futation/Bionic_Snake_Robot/hardware/BOM_Bus-LinkV2.1_bus-linkV2.1_2026-06-18.xlsx

No. | Quantity | Comment | Designator | Footprint | Value | Manufacturer Part | Manufacturer | Supplier Part | Supplier
1 | 3 | 100nF | C1,C17,C21 | C0603 | 100nF | CC0603KRX7R9BB104 | YAGEO(国巨) | C14663 | LCSC
2 | 2 | 10uF | C2,C22 | C1206 | 10uF | CL31B106KBHNNNE | SAMSUNG(三星) | C89632 | LCSC
3 | 1 | 10nF | C3 | C0603 | 10nF | CL10B103KB8NNNC | SAMSUNG(三星) | C1589 | LCSC
4 | 1 | 220uF | C4 | CAP-SMD_BD6.3-L6.6-W6.6-LS7.3-FD-H7.7 | 220uF | JVJ25V220M6x8 | JIERR(捷而瑞) | C46550404 | LCSC
5 | 1 | 330nF | C5 | C0603 | 330nF | FCC0603B334K500CT | FOJAN(富捷) | C7419419 | LCSC
6 | 2 | 100nF | C15,C16 | C0603 |  | CGA0603X7R104K500JT | HRE(芯声) | C6119867 | LCSC
7 | 1 | 1000uF | C19 | CAP-TH_BD10.0-F5.00-D0.6-FD | 1000uF | PA35V1000M10x15 | JIERR(捷而瑞) | C46550434 | LCSC
8 | 1 | 330uF | C24 | CAP-TH_BD6.3-P2.50-D0.6-FD-1 | 330uF | PA16V330M6x9 | JIERR(捷而瑞) | C46550446 | LCSC
9 | 2 | PH-3A | CN4,CN5 | CONN-TH_3P-P2.00_HCTL_PH-3A_C2908624 |  | PH-3A | HCTL(华灿天禄) | C2908624 | LCSC
10 | 1 | 1SMA5927A | D2 | SMA_L4.3-W2.6-LS5.0-RD |  | 1SMA5927A | R+O(宏嘉诚) | C19077489 | LCSC
11 | 1 | SMAJ15CA | D3 | SMA_L4.3-W2.6-LS5.0-BI |  | SMAJ15CA | R+O(宏嘉诚) | C19077536 | LCSC
12 | 1 | SS54 | D4 | SMA_L4.3-W2.6-LS5.0-FD |  | SS54 | R+O(宏嘉诚) | C7420369 | LCSC
13 | 1 | ST2045 | D5 | TO-277_3P-L5.4-W4.0-LS6.5-BR |  | ST2045 | MDD(辰达半导体) | C840773 | LCSC
14 | 1 | DC-005-A200 | DC2 | DC-IN-TH_DC-005-A200 |  | DC-005-A200 | XUNPU(讯普) | C720557 | LCSC
15 | 1 | BSMD1206-300-6V | F1 | F1206 |  | BSMD1206-300-6V | BHFUSE(佰宏) | C883136 | LCSC
16 | 1 | 2920L1400SL16GRG | F2 | F2920 |  | 2920L1400SL16GRG | LUTE(陆特) | C49196651 | LCSC
17 | 2 | PZ254V-11-07P | H2,H3 | HDR-TH_7P-P2.54-V-M |  | PZ254V-11-07P | XFCN(兴飞) | C492406 | LCSC
18 | 1 | 22uH | L1 | IND-SMD_L7.3-W6.6 | 22uH | YSPI0740-220M | YJYCOIN(益嘉源) | C718397 | LCSC
19 | 3 | XL-1608SURC-06 | LED1,RX,TX | LED0603-RD_RED |  | XL-1608SURC-06 | XINGLIGHT(成兴光) | C965799 | LCSC
20 | 1 | AOD4185 | Q1 | TO-252-3_L6.6-W6.1-P4.57-LS9.9-BR-CW |  | AOD4185 | AOS | C400894 | LCSC
21 | 5 | 1kΩ | R1,R7,R8,R9,R11 | R0603 | 1kΩ | 0603WAF1001T5E | UNI-ROYAL(厚声) | C21190 | LCSC
22 | 1 | 10kΩ | R2 | R0603 | 10kΩ | FRC0603F1002TS | FOJAN(富捷) | C2906982 | LCSC
23 | 1 | 3.24kΩ | R3 | R0603 | 3.24kΩ | 0603WAF3241T5E | UNI-ROYAL(厚声) | C22994 | LCSC
24 | 1 | 500kΩ | R4 | R0603 | 500kΩ | AR03BTCX5003N | Viking(光颉) | C2902631 | LCSC
25 | 1 | 100kΩ | R5 | R0603 | 100kΩ | RT0603BRD07100KL | YAGEO(国巨) | C122538 | LCSC
26 | 1 | 0Ω | R6 | R1206 | 0Ω | RE1206F1R000 | JIERR(捷而瑞) | C46961765 | LCSC
27 | 2 | 47Ω | R17,R18 | R0603 | 47Ω | 0603WAF470JT5E | UNI-ROYAL(厚声) | C23182 | LCSC
28 | 1 | SS-12D10L5 | SW1 | SW-TH_SS-12D10L5 |  | SS-12D10L5 | XKB Connection(中国星坤) | C319012 | LCSC
29 | 1 | MC74HC126ADR2G | U2 | SOIC-14_L8.7-W3.9-P1.27-LS6.0-BL |  | MC74HC126ADR2G | onsemi(安森美) | C233530 | LCSC
30 | 1 | ESP32-S3-Zero 排针板 | U4 | ESP32-S3-Zero 排针
31 | 1 | 74AHC1G04W5-7 | U5 | SOT-25_L3.0-W1.6-P0.95-LS2.8-BL |  | 74AHC1G04W5-7 | DIODES(美台) | C460486 | LCSC
32 | 1 | TPS5430DDAR | U7 | ESOP-8_L4.9-W3.9-P1.27-LS6.0-TL-EP |  | TPS5430DDAR | TI(德州仪器) | C9864 | LCSC
33 | 2 | ZX-QC66-7.5TP | U8,U9 | KEY-SMD_4P-L6.0-W6.0-P4.50-LS8.6 |  | ZX-QC66-7.5TP | Megastar(兆星) | C7470157 | LCSC
