futation/Bionic_Snake_Robot/docs/运动算法/算法提炼.pdf

# 理论模型

# 连续模型

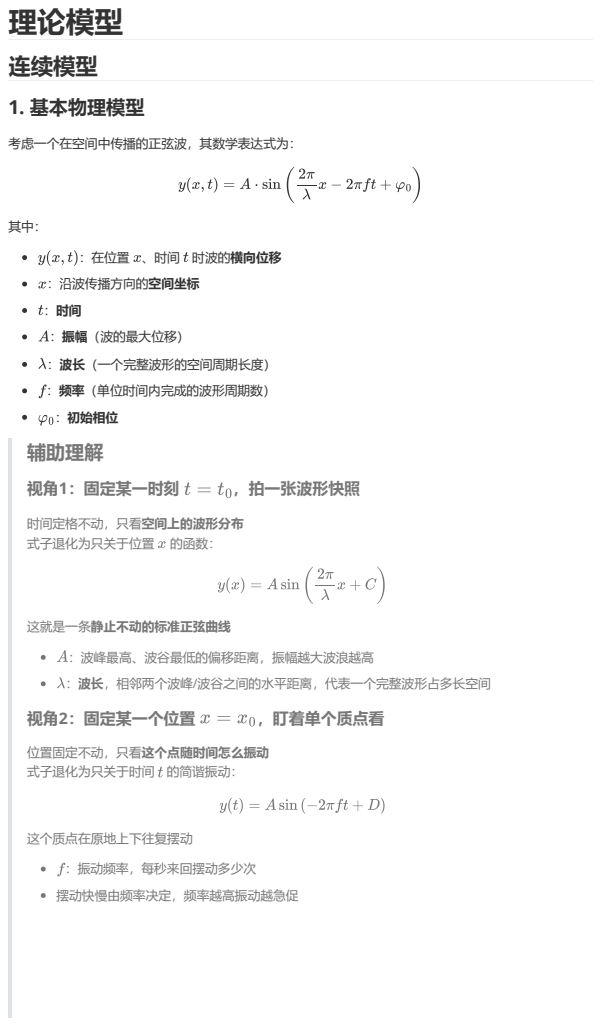
[picture p25: page 1]
1. 基本物理模型; 考虑一个在空间中传播的正弦波，其数学表达式为：; 视角1：固定某一时刻; ，拍一张波形快照; 时间定格不动，只看空间上的波形分布 式子退化为只关于位置 的函数：; 视角2：固定某一个位置; ，盯着单个质点看; 位置固定不动，只看这个点随时间怎么振动 式子退化为只关于时间 的简谐振动：; 这个质点在原地上下往复摆动; ：振动频率，每秒来回摆动多少次; 摆动快慢由频率决定，频率越高振动越急促

：在位置 、时间 时波的横向位移
：沿波传播方向的空间坐标
：振幅（波的最大位移）
：波长（一个完整波形的空间周期长度）
：频率（单位时间内完成的波形周期数）
：初始相位
辅助理解

这就是一条静止不动的标准正弦曲线
：波峰最高、波谷最低的偏移距离，振幅越大波浪越高
：波长，相邻两个波峰/波谷之间的水平距离，代表一个完整波形占多长空间

### 图像理解：二维动态波形图

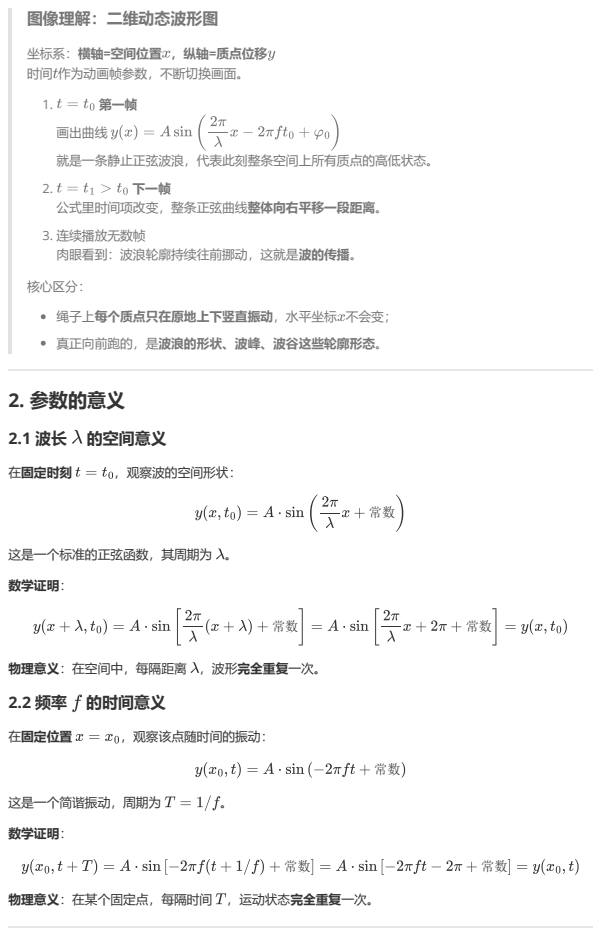
[picture p26: page 2]
2. 参数的意义; 2.1 波长 的空间意义; 在固定时刻; ，观察波的空间形状：; 这是一个标准的正弦函数，其周期为 。; 数学证明：; 在固定位置; ，观察该点随时间的振动：; 这是一个简谐振动，周期为

坐标系：横轴=空间位置 ，纵轴=质点位移
时间 作为动画帧参数，不断切换画面。
1. 第一帧
画出曲线
就是一条静止正弦波浪，代表此刻整条空间上所有质点的高低状态。
2. 下一帧
公式里时间项改变，整条正弦曲线整体向右平移一段距离。
3. 连续播放无数帧
肉眼看到：波浪轮廓持续往前挪动，这就是波的传播。

核心区分：
绳子上每个质点只在原地上下竖直振动，水平坐标 不会变；
真正向前跑的，是波浪的形状、波峰、波谷这些轮廓形态。

物理意义：在空间中，每隔距离 ，波形完全重复一次。
2.2 频率 的时间意义

物理意义：在某个固定点，每隔时间 ，运动状态完全重复一次。

## 3. 波的传播速度(相速度)

# 离散化变换

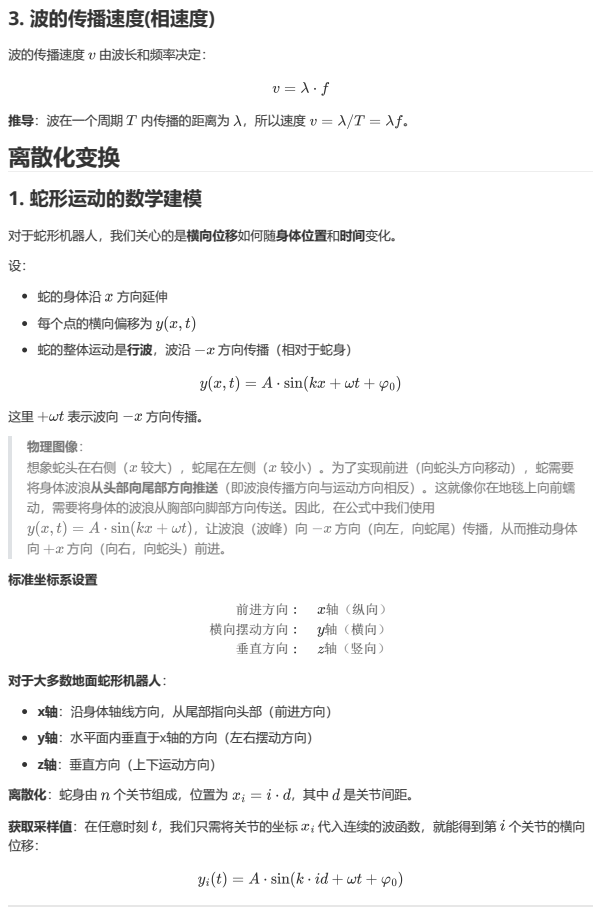
[picture p27: page 3]
波的传播速度 由波长和频率决定：; 推导：波在一个周期 内传播的距离为 ，所以速度; 1. 蛇形运动的数学建模; 对于蛇形机器人，我们关心的是横向位移如何随身体位置和时间变化。; 蛇的身体沿 方向延伸; 每个点的横向偏移为; 蛇的整体运动是行波，波沿; 方向传播（相对于蛇身）; 表示波向; 方向传播。; ，让波浪（波峰）向; 方向（向左，向蛇尾）传播，从而推动身体; 方向（向右，向蛇头）前进。; 标准坐标系设置; 前进方向; 横向摆动方向; 垂直方向; 对于大多数地面蛇形机器人：; 离散化：蛇身由 个关节组成，位置为; ，其中 是关节间距。; 获取采样值：在任意时刻 ，我们只需将关节的坐标; 代入连续的波函数，就能得到第 个关节的横向

物理图像：
想象蛇头在右侧（ 较大），蛇尾在左侧（ 较小）。为了实现前进（向蛇头方向移动），蛇需要
将身体波浪从头部向尾部方向推送（即波浪传播方向与运动方向相反）。这就像你在地毯上向前蠕
动，需要将身体的波浪从胸部向脚部方向传送。因此，在公式中我们使用

x轴：沿身体轴线方向，从尾部指向头部（前进方向）
y轴：水平面内垂直于x轴的方向（左右摆动方向）
z轴：垂直方向（上下运动方向）

## 2. 从连续到离散的关键转换

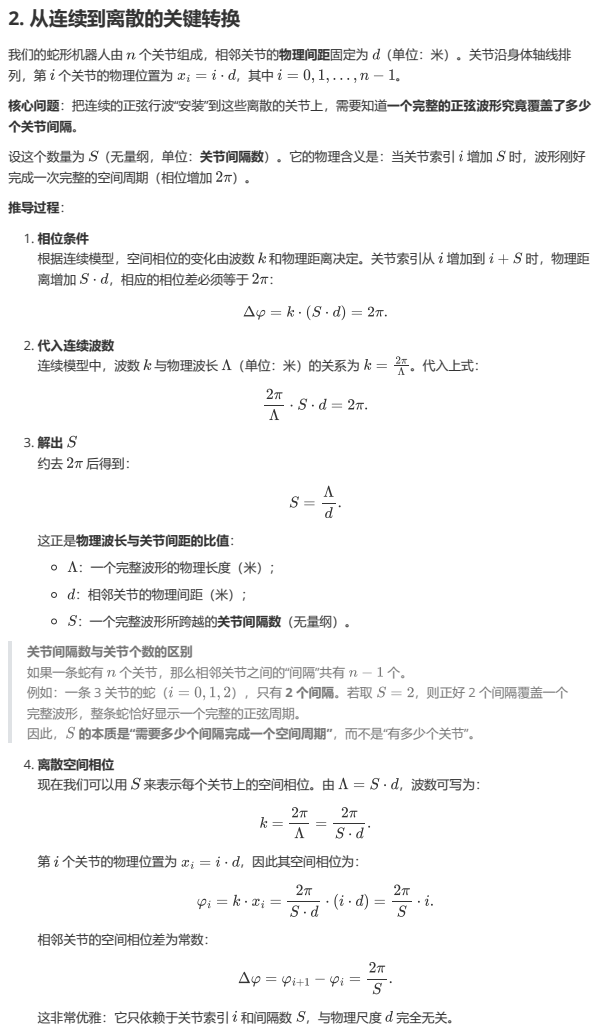
[picture p28: page 4]
列，第 个关节的物理位置为; 完成一次完整的空间周期（相位增加; 根据连续模型，空间相位的变化由波数 和物理距离决定。关节索引从 增加到; 时，物理距; 离增加; ，相应的相位差必须等于; 2. 代入连续波数; 连续模型中，波数 与物理波长 （单位：米）的关系为; 。代入上式：; 后得到：; 如果一条蛇有 个关节，那么相邻关节之间的“间隔”共有; 例如：一条 3 关节的蛇（; ），只有 2 个间隔。若取; ，则正好 2 个间隔覆盖一个; 现在我们可以用 来表示每个关节上的空间相位。由; ，波数可写为：; 第 个关节的物理位置为; ，因此其空间相位为：; 相邻关节的空间相位差为常数：

我们的蛇形机器人由 个关节组成，相邻关节的物理间距固定为 （单位：米）。关节沿身体轴线排
核心问题：把连续的正弦行波“安装”到这些离散的关节上，需要知道一个完整的正弦波形究竟覆盖了多少
个关节间隔。
设这个数量为 （无量纲，单位：关节间隔数）。它的物理含义是：当关节索引 增加 时，波形刚好
推导过程：
1. 相位条件

这正是物理波长与关节间距的比值：
：一个完整波形的物理长度（米）；
：相邻关节的物理间距（米）；
：一个完整波形所跨越的关节间隔数（无量纲）。
关节间隔数与关节个数的区别
完整波形，整条蛇恰好显示一个完整的正弦周期。
因此， 的本质是“需要多少个间隔完成一个空间周期”，而不是“有多少个关节”。
4. 离散空间相位

这非常优雅：它只依赖于关节索引 和间隔数 ，与物理尺度 完全无关。

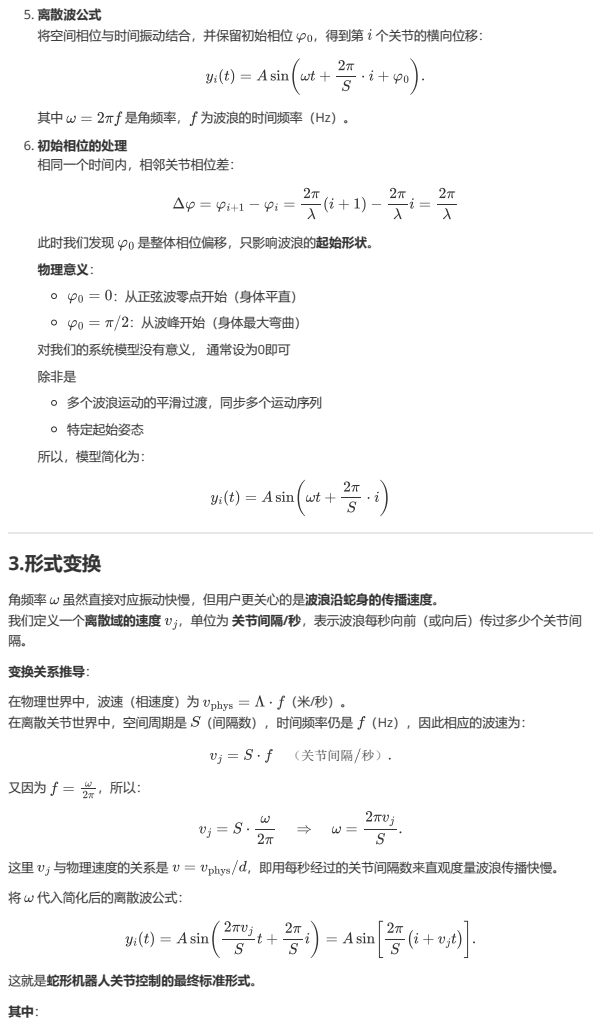
[picture p29: page 5]
5. 离散波公式; 将空间相位与时间振动结合，并保留初始相位; ，得到第 个关节的横向位移：; 是角频率， 为波浪的时间频率（Hz）。; 6. 初始相位的处理 相同一个时间内，相邻关节相位差：; 此时我们发现; 是整体相位偏移，只影响波浪的起始形状。; 物理意义：; ：从正弦波零点开始（身体平直）; ：从波峰开始（身体最大弯曲）; 对我们的系统模型没有意义， 通常设为0即可; 除非是; 多个波浪运动的平滑过渡，同步多个运动序列; 特定起始姿态; 所以，模型简化为：; 3.形式变换; 在物理世界中，波速（相速度）为; （关节间隔 秒）; 又因为; 与物理速度的关系是; ，即用每秒经过的关节间隔数来直观度量波浪传播快慢。; 将 代入简化后的离散波公式：; 这就是蛇形机器人关节控制的最终标准形式。

角频率 虽然直接对应振动快慢，但用户更关心的是波浪沿蛇身的传播速度。
我们定义一个离散域的速度 ，单位为 关节间隔/秒，表示波浪每秒向前（或向后）传过多少个关节间
变换关系推导：
在离散关节世界中，空间周期是 （间隔数），时间频率仍是 （Hz），因此相应的波速为：

# 实际应用

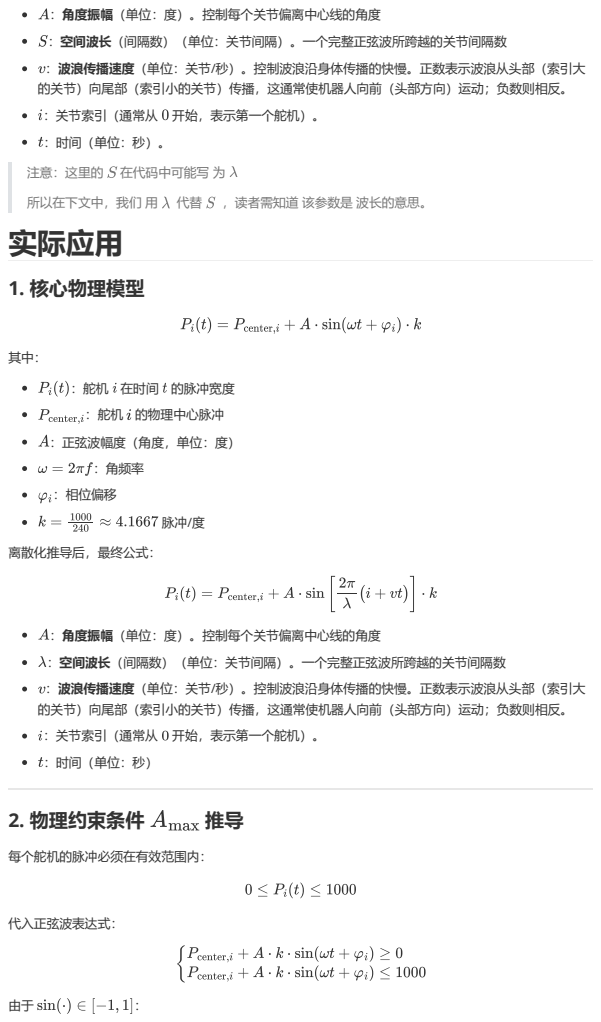
[picture p30: page 6]
所以在下文中，我们 用 代替; ，读者需知道 该参数是 波长的意思。; 1. 核心物理模型; 离散化推导后，最终公式：; 2. 物理约束条件; 每个舵机的脉冲必须在有效范围内：; 代入正弦波表达式：

：角度振幅（单位：度）。控制每个关节偏离中心线的角度
：空间波长（间隔数）（单位：关节间隔）。一个完整正弦波所跨越的关节间隔数
：波浪传播速度（单位：关节/秒）。控制波浪沿身体传播的快慢。正数表示波浪从头部（索引大
的关节）向尾部（索引小的关节）传播，这通常使机器人向前（头部方向）运动；负数则相反。
：关节索引（通常从 开始，表示第一个舵机）。
注意：这里的 在代码中可能写 为

：舵机 在时间 的脉冲宽度
：舵机 的物理中心脉冲
：正弦波幅度（角度，单位：度）
：角频率
：相位偏移

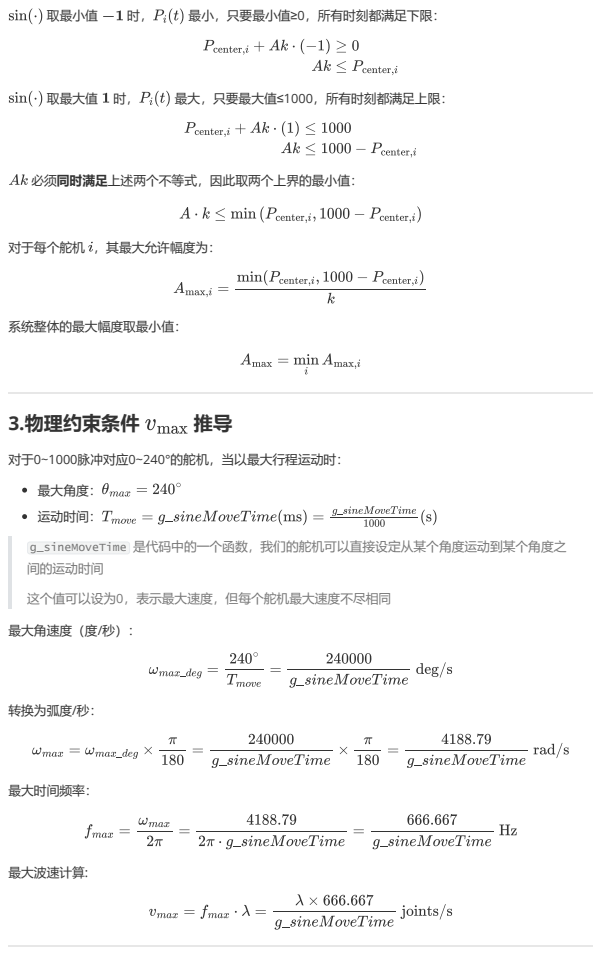
[picture p31: page 7]
取最小值; 最小，只要最小值≥0，所有时刻都满足下限：; 取最大值 时，; 最大，只要最大值≤1000，所有时刻都满足上限：; 必须同时满足上述两个不等式，因此取两个上界的最小值：; 对于每个舵机 ，其最大允许幅度为：; 系统整体的最大幅度取最小值：; 3.物理约束条件; 对于0~1000脉冲对应0~240°的舵机，当以最大行程运动时：; 最大角度：; 运动时间：; g_sineMoveTime 是代码中的一个函数，我们的舵机可以直接设定从某个角度运动到某个角度之 间的运动时间; 这个值可以设为0，表示最大速度，但每个舵机最大速度不尽相同; 最大角速度（度/秒）：; 转换为弧度/秒：; 最大时间频率：; 最大波速计算:

## 4. 约束条件推导

### ：数学无定义，系统崩溃

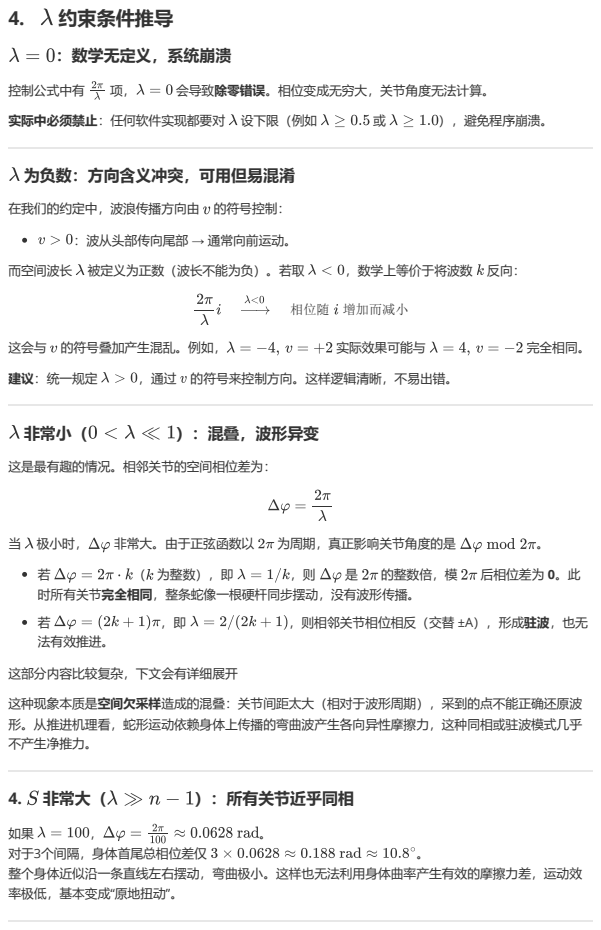
[picture p32: page 8]
控制公式中有; 会导致除零错误。相位变成无穷大，关节角度无法计算。; 实际中必须禁止：任何软件实现都要对 设下限（例如; ），避免程序崩溃。; ：波从头部传向尾部 → 通常向前运动。; 而空间波长 被定义为正数（波长不能为负）。若取; ，数学上等价于将波数 反向：; 相位随 增加而减小; 这会与 的符号叠加产生混乱。例如，; 实际效果可能与; 完全相同。; 建议：统一规定; ，通过 的符号来控制方向。这样逻辑清晰，不易出错。; 非常小（; ）：混叠，波形异变; 这是最有趣的情况。相邻关节的空间相位差为：; 当 极小时，; 非常大。由于正弦函数以; 为周期，真正影响关节角度的是; （ 为整数），即; 的整数倍，模; 后相位差为 0。此; ，则相邻关节相位相反（交替 ±A），形成驻波，也无; 4. 非常大（; ）：所有关节近乎同相; 对于3个间隔，身体首尾总相位差仅

为负数：方向含义冲突，可用但易混淆

在我们的约定中，波浪传播方向由 的符号控制：

时所有关节完全相同，整条蛇像一根硬杆同步摆动，没有波形传播。
法有效推进。

这部分内容比较复杂，下文会有详细展开
这种现象本质是空间欠采样造成的混叠：关节间距太大（相对于波形周期），采到的点不能正确还原波
形。从推进机理看，蛇形运动依赖身体上传播的弯曲波产生各向异性摩擦力，这种同相或驻波模式几乎
不产生净推力。

整个身体近似沿一条直线左右摆动，弯曲极小。这样也无法利用身体曲率产生有效的摩擦力差，运动效
率极低，基本变成“原地扭动”。

# S的陷阱值

# 绝对陷阱

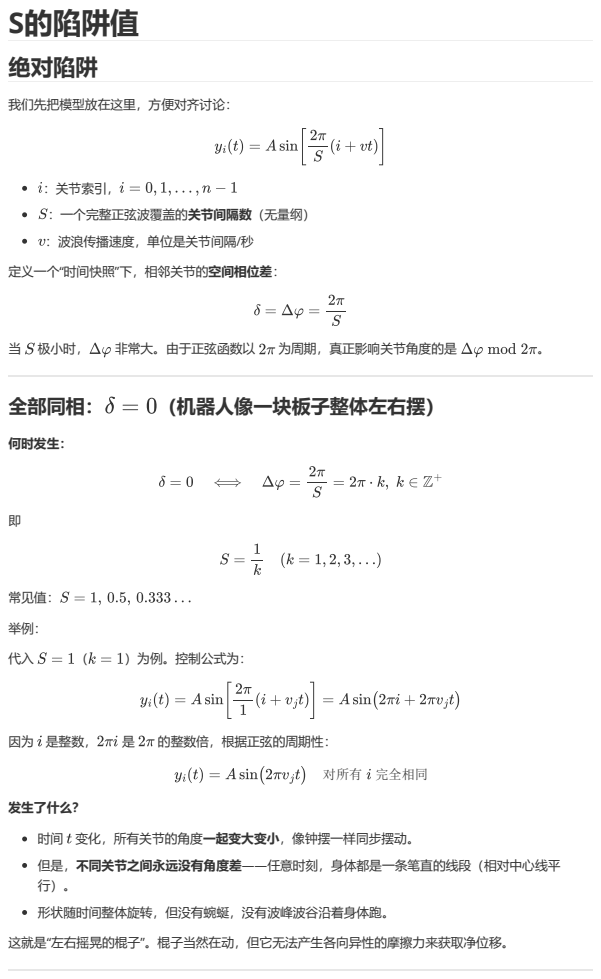
[picture p33: page 9]
我们先把模型放在这里，方便对齐讨论：; 当 极小时，; 非常大。由于正弦函数以; 为周期，真正影响关节角度的是; 全部同相：; （机器人像一块板子整体左右摆）; 何时发生：; 常见值：; ）为例。控制公式为：; 因为 是整数，; 的整数倍，根据正弦的周期性：; 对所有 完全相同; 发生了什么？

：关节索引，
：一个完整正弦波覆盖的关节间隔数（无量纲）
：波浪传播速度，单位是关节间隔/秒
定义一个“时间快照”下，相邻关节的空间相位差：

时间 变化，所有关节的角度一起变大变小，像钟摆一样同步摆动。
但是，不同关节之间永远没有角度差——任意时刻，身体都是一条笔直的线段（相对中心线平
形状随时间整体旋转，但没有蜿蜒，没有波峰波谷沿着身体跑。
这就是“左右摇晃的棍子”。棍子当然在动，但它无法产生各向异性的摩擦力来获取净位移。

## 相邻反相： （锯齿形驻波，身体像拉链）

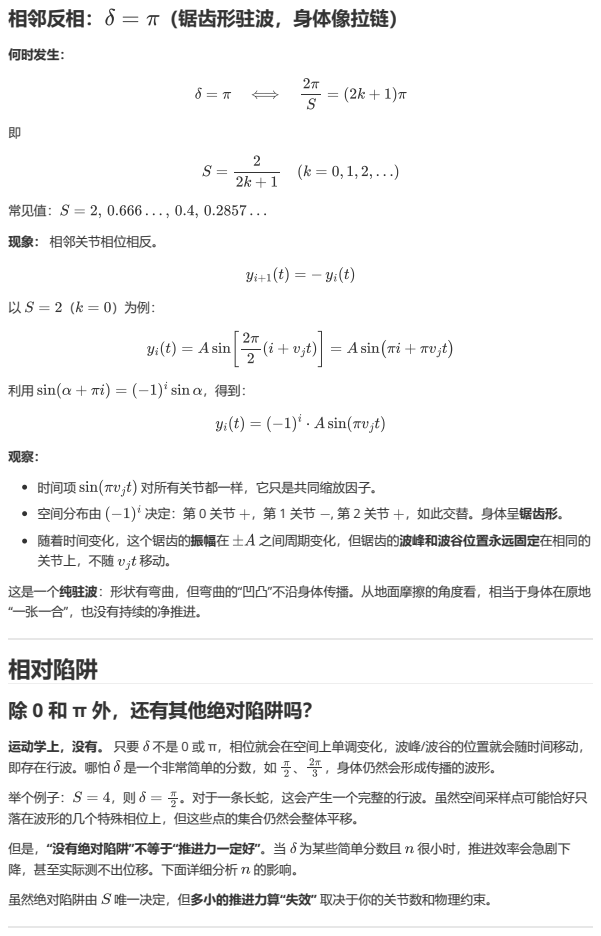
[picture p34: page 10]
何时发生：; 常见值：; 现象： 相邻关节相位相反。; 时间项; 对所有关节都一样，它只是共同缩放因子。; 空间分布由; 决定：第 0 关节 ，第 1 关节 , 第 2 关节 ，如此交替。身体呈锯齿形。; 随着时间变化，这个锯齿的振幅在; 之间周期变化，但锯齿的波峰和波谷位置永远固定在相同的; 关节上，不随; 举个例子：; 。对于一条长蛇，这会产生一个完整的行波。虽然空间采样点可能恰好只

这是一个纯驻波：形状有弯曲，但弯曲的“凹凸”不沿身体传播。从地面摩擦的角度看，相当于身体在原地
“一张一合”，也没有持续的净推进。
相对陷阱
除 0 和 π 外，还有其他绝对陷阱吗？

运动学上，没有。 只要 不是 0 或 π，相位就会在空间上单调变化，波峰/波谷的位置就会随时间移动，
即存在行波。哪怕 是一个非常简单的分数，如 、 ，身体仍然会形成传播的波形。
落在波形的几个特殊相位上，但这些点的集合仍然会整体平移。
但是，“没有绝对陷阱”不等于“推进力一定好”。当 为某些简单分数且 很小时，推进效率会急剧下
降，甚至实际测不出位移。下面详细分析 的影响。
虽然绝对陷阱由 唯一决定，但多小的推进力算“失效” 取决于你的关节数和物理约束。

## 身体总相位跨度决定“波形丰度”

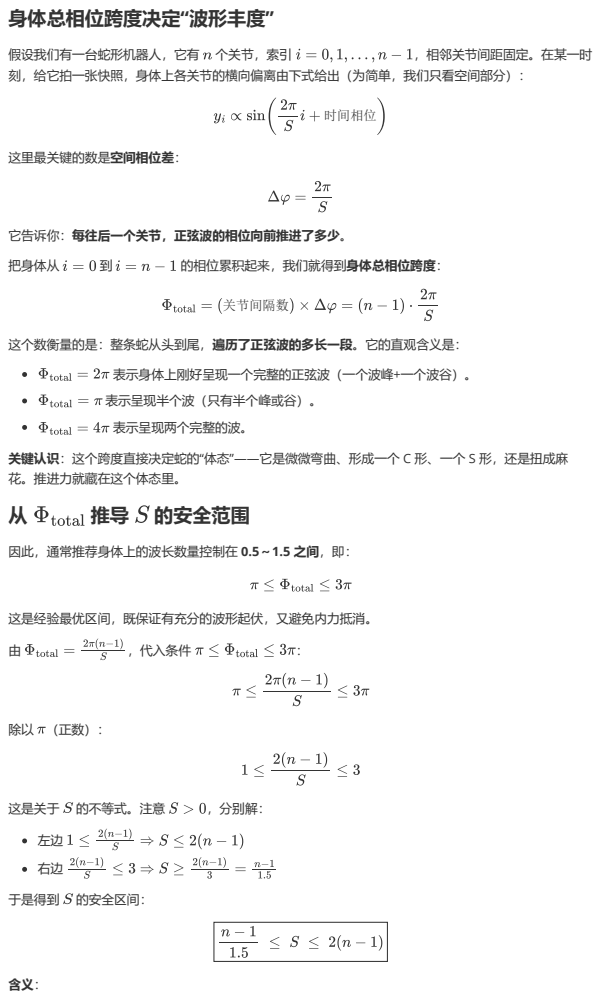
[picture p35: page 11]
假设我们有一台蛇形机器人，它有 个关节，索引; ，相邻关节间距固定。在某一时; 时间相位; 这里最关键的数是空间相位差：; 把身体从; 的相位累积起来，我们就得到身体总相位跨度：; 关节间隔数; 推导 的安全范围; ，代入条件; 这是关于 的不等式。注意; ，分别解：; 于是得到 的安全区间：

刻，给它拍一张快照，身体上各关节的横向偏离由下式给出（为简单，我们只看空间部分）：

它告诉你：每往后一个关节，正弦波的相位向前推进了多少。

这个数衡量的是：整条蛇从头到尾，遍历了正弦波的多长一段。它的直观含义是：

表示身体上刚好呈现一个完整的正弦波（一个波峰+一个波谷）。
表示呈现半个波（只有半个峰或谷）。
表示呈现两个完整的波。

关键认识：这个跨度直接决定蛇的“体态”——它是微微弯曲、形成一个 C 形、一个 S 形，还是扭成麻
花。推进力就藏在这个体态里。

因此，通常推荐身体上的波长数量控制在 0.5～1.5 之间，即：

这是经验最优区间，既保证有充分的波形起伏，又避免内力抵消。

## 结合陷阱值，看小 时为什么危险

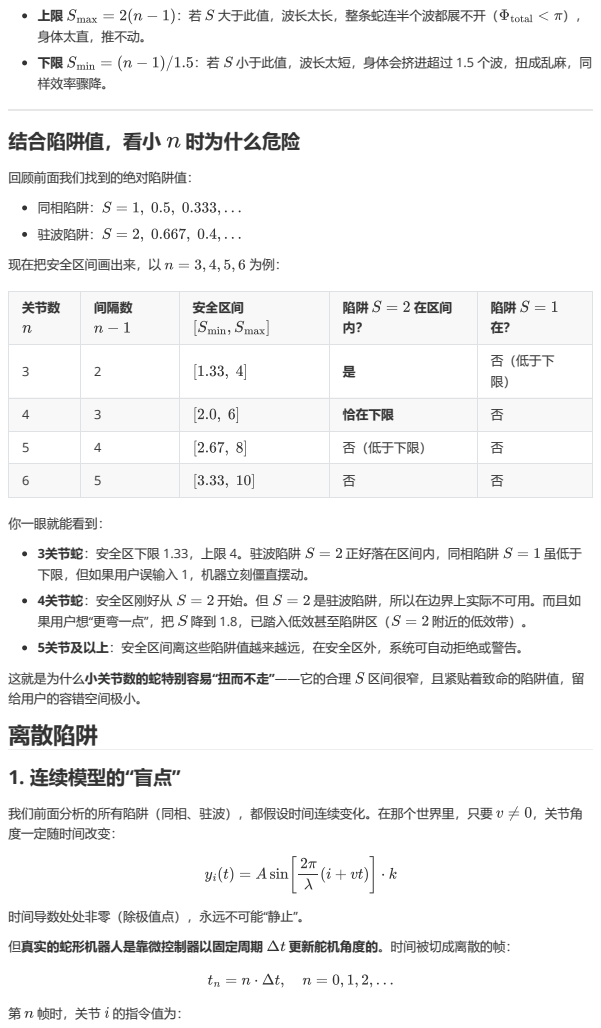
[picture p36: page 12]
：若 大于此值，波长太长，整条蛇连半个波都展不开（; 身体太直，推不动。; ：若 小于此值，波长太短，身体会挤进超过 1.5 个波，扭成乱麻，同; 样效率骤降。; 回顾前面我们找到的绝对陷阱值：; 同相陷阱：; 驻波陷阱：; 现在把安全区间画出来，以; 3关节蛇：安全区下限 1.33，上限 4。驻波陷阱; 正好落在区间内，同相陷阱; 虽低于; 4关节蛇：安全区刚好从; 是驻波陷阱，所以在边界上实际不可用。而且如; 果用户想“更弯一点”，把 降到 1.8，已踏入低效甚至陷阱区（; 附近的低效带）。; 我们前面分析的所有陷阱（同相、驻波），都假设时间连续变化。在那个世界里，只要; ，关节角; 度一定随时间改变：; 但真实的蛇形机器人是靠微控制器以固定周期; 更新舵机角度的。时间被切成离散的帧：

关节数 | 间隔数 | 安全区间 | 陷阱 在区间 内？ | 陷阱 在？

3 | 2 | | | | 是 | 否（低于下 限）

4 | 3 | | | | 恰在下限 | 否

5 | 4 | | | | 否（低于下限） | 否

你一眼就能看到：
下限，但如果用户误输入 1，机器立刻僵直摆动。
5关节及以上：安全区间离这些陷阱值越来越远，在安全区外，系统可自动拒绝或警告。
这就是为什么小关节数的蛇特别容易“扭而不走”——它的合理 区间很窄，且紧贴着致命的陷阱值，留
给用户的容错空间极小。
离散陷阱
1. 连续模型的“盲点”

时间导数处处非零（除极值点），永远不可能“静止”。

第 帧时，关节 的指令值为：

## 2. 静态动作的精确条件：频闪冻结

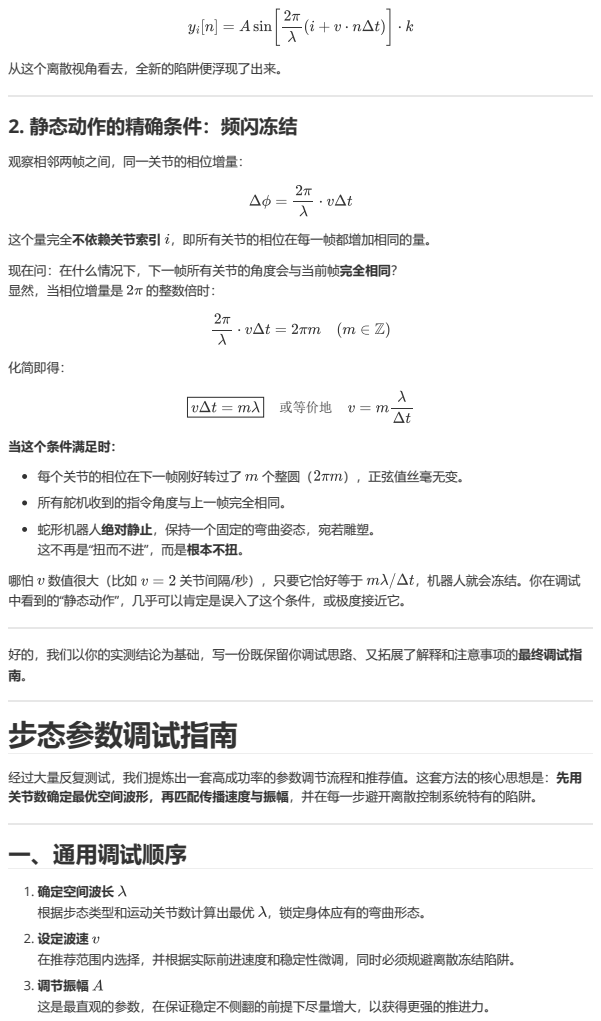
[picture p37: page 13]
从这个离散视角看去，全新的陷阱便浮现了出来。; 观察相邻两帧之间，同一关节的相位增量：; 这个量完全不依赖关节索引 ，即所有关节的相位在每一帧都增加相同的量。; 显然，当相位增量是; 的整数倍时：; 化简即得：; 或等价地; 每个关节的相位在下一帧刚好转过了; 个整圆（; ），正弦值丝毫无变。; 哪怕 数值很大（比如; 关节间隔/秒），只要它恰好等于; ，机器人就会冻结。你在调试

现在问：在什么情况下，下一帧所有关节的角度会与当前帧完全相同？

当这个条件满足时：
所有舵机收到的指令角度与上一帧完全相同。
蛇形机器人绝对静止，保持一个固定的弯曲姿态，宛若雕塑。
这不再是“扭而不进”，而是根本不扭。
中看到的“静态动作”，几乎可以肯定是误入了这个条件，或极度接近它。

好的，我们以你的实测结论为基础，写一份既保留你调试思路、又拓展了解释和注意事项的最终调试指
步态参数调试指南

经过大量反复测试，我们提炼出一套高成功率的参数调节流程和推荐值。这套方法的核心思想是：先用
关节数确定最优空间波形，再匹配传播速度与振幅，并在每一步避开离散控制系统特有的陷阱。
一、通用调试顺序

1. 确定空间波长
根据步态类型和运动关节数计算出最优 ，锁定身体应有的弯曲形态。
2. 设定波速
在推荐范围内选择，并根据实际前进速度和稳定性微调，同时必须规避离散冻结陷阱。
3. 调节振幅
这是最直观的参数，在保证稳定不侧翻的前提下尽量增大，以获得更强的推进力。

# 二、蜿蜒步态

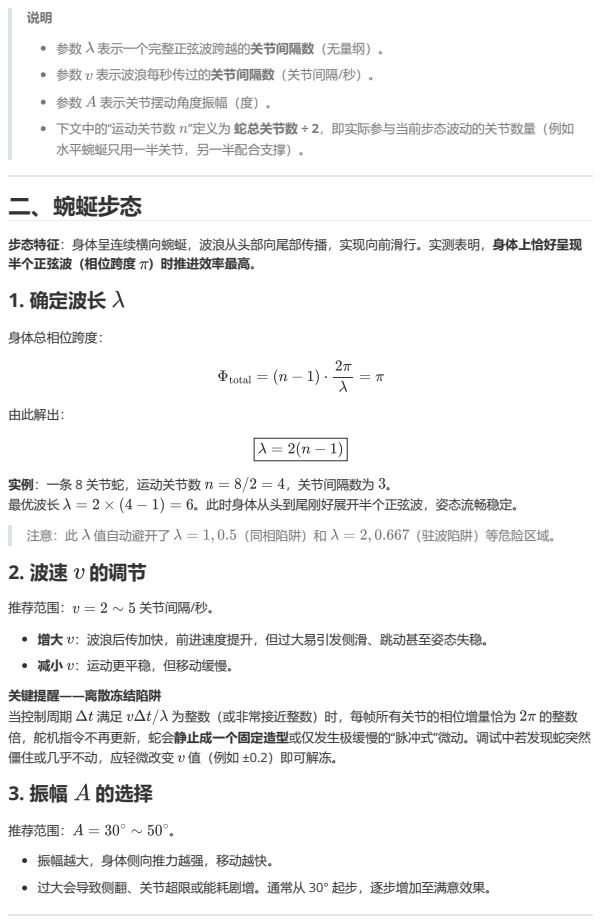
[picture p38: page 14]
身体总相位跨度：; 由此解出：; 实例：一条 8 关节蛇，运动关节数; ，关节间隔数为 。; 最优波长; 。此时身体从头到尾刚好展开半个正弦波，姿态流畅稳定。; 注意：此 值自动避开了; （同相陷阱）和; （驻波陷阱）等危险区域。; 2. 波速 的调节; 推荐范围：; 关节间隔/秒。; 当控制周期; 为整数（或非常接近整数）时，每帧所有关节的相位增量恰为; 的整数

参数 表示一个完整正弦波跨越的关节间隔数（无量纲）。
参数 表示波浪每秒传过的关节间隔数（关节间隔/秒）。
参数 表示关节摆动角度振幅（度）。
下文中的“运动关节数 ”定义为 蛇总关节数 ÷ 2，即实际参与当前步态波动的关节数量（例如
水平蜿蜒只用一半关节，另一半配合支撑）。

步态特征：身体呈连续横向蜿蜒，波浪从头部向尾部传播，实现向前滑行。实测表明，身体上恰好呈现
半个正弦波（相位跨度 ）时推进效率最高。
1. 确定波长

增大 ：波浪后传加快，前进速度提升，但过大易引发侧滑、跳动甚至姿态失稳。
减小 ：运动更平稳，但移动缓慢。
关键提醒——离散冻结陷阱
倍，舵机指令不再更新，蛇会静止成一个固定造型或仅发生极缓慢的“脉冲式”微动。调试中若发现蛇突然
僵住或几乎不动，应轻微改变 值（例如 ±0.2）即可解冻。
3. 振幅 的选择

振幅越大，身体侧向推力越强，移动越快。
过大会导致侧翻、关节超限或能耗剧增。通常从 30° 起步，逐步增加至满意效果。

# 三、蠕动步态

## 1. 确定波长

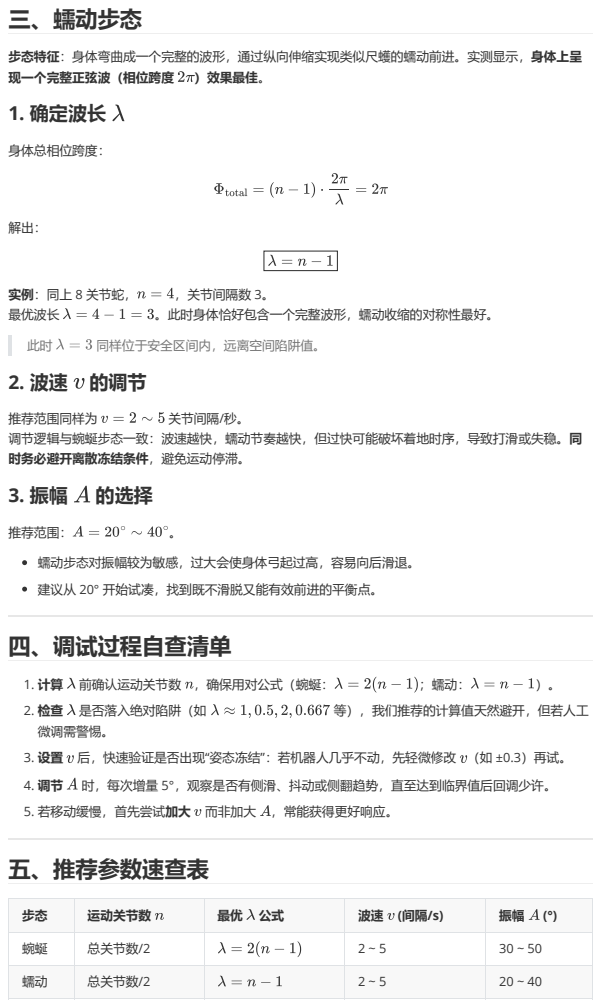
[picture p39: page 15]
身体总相位跨度：; 实例：同上 8 关节蛇，; ，关节间隔数 3。; 最优波长; 。此时身体恰好包含一个完整波形，蠕动收缩的对称性最好。; 同样位于安全区间内，远离空间陷阱值。; 2. 波速 的调节; 推荐范围同样为; 关节间隔/秒。; 推荐范围：; 1. 计算 前确认运动关节数 ，确保用对公式（蜿蜒：; 2. 检查 是否落入绝对陷阱（如; 等），我们推荐的计算值天然避开，但若人工

步态特征：身体弯曲成一个完整的波形，通过纵向伸缩实现类似尺蠖的蠕动前进。实测显示，身体上呈
现一个完整正弦波（相位跨度 ）效果最佳。

调节逻辑与蜿蜒步态一致：波速越快，蠕动节奏越快，但过快可能破坏着地时序，导致打滑或失稳。同
时务必避开离散冻结条件，避免运动停滞。
3. 振幅 的选择

蠕动步态对振幅较为敏感，过大会使身体弓起过高，容易向后滑退。
建议从 20° 开始试凑，找到既不滑脱又能有效前进的平衡点。
四、调试过程自查清单

微调需警惕。
3. 设置 后，快速验证是否出现“姿态冻结”：若机器人几乎不动，先轻微修改 （如 ±0.3）再试。
4. 调节 时，每次增量 5°，观察是否有侧滑、抖动或侧翻趋势，直至达到临界值后回调少许。
5. 若移动缓慢，首先尝试加大 而非加大 ，常能获得更好响应。
五、推荐参数速查表

步态 | 运动关节数 | 最优 公式 | 波速 (间隔/s) | 振幅 (°)

蜿蜒 | 总关节数/2 | | 2 ~ 5 | 30 ~ 50

蠕动 | 总关节数/2 | | 2 ~ 5 | 20 ~ 40
